Makerfabs/ESP32-S3-Parallel-TFT-with-Touch-7inch/example/ESP32_Display_Panel/README.md

This example demonstrates how to run the Espressif ESP32_Display_Pane library on 
[MaTouch ESP32-S3 Parallel TFT with Touch 7"](https://github.com/esp-arduino-libs/ESP32_Display_Panel/releases)

More detailed information you can get from 


## Preparation

📖 Here are the usage guides for ESP32_Display_Panel in Arduino development environments:

* [Arduino IDE 2.3.4](./docs/envs/use_with_arduino.md)

## Supported Boards

📋 Here is the list of boards supported by ESP32_Display_Panel:

| **Manufacturer** | **Model** |
| --- | --- |
| [Makerfabs] |MaTouch ESP32-S3 Parallel TFT with Touch 7"  |

## Supported Controllers

### LCD Controllers

📌 Here is the list of LCD controllers useded by MaTouch ESP32-S3 Parallel TFT with Touch 7":

| **Manufacturer** | **Model** |
| --- | --- |
| Sitronix | ST7262 |

### Touch Controllers

📋 Here is the list of touch controllers used by MaTouch ESP32-S3 Parallel TFT with Touch 7":

| **Manufacturer** | **Model** |
| --- | --- |
| GOODiX | GT911 |

## How to Use

1. Install ESP32 package v3.1.1 first and replace with the esp32-3.1.1-h[high_perf version](https://github.com/esp-arduino-libs/ESP32_Display_Panel/blob/master/docs/envs/use_with_arduino.md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)

2. Install Espressif ESP32_Display_Panel Library 1.0.2

3. Open the example with Arduino IDE 2.3.4 or above.
   
3.1 Select Board ESP32S3 Dev Module

3.2 Select PSRAM from none to “OPI PSRAM”

## Compiled info
Using library ESP32_Display_Panel at version 1.0.2 in folder: C:\Users\miand\Documents\Arduino\libraries\ESP32_Display_Panel 

Using library esp-lib-utils at version 0.1.2 in folder: C:\Users\miand\Documents\Arduino\libraries\esp-lib-utils 

Using library ESP32_IO_Expander at version 1.0.1 in folder: C:\Users\miand\Documents\Arduino\libraries\ESP32_IO_Expander 

Using library lvgl at version 8.3.11 in folder: C:\Users\miand\Documents\Arduino\libraries\lvgl 

Using library ui at version 1.0 in folder: C:\Users\miand\Documents\Arduino\libraries\ui
