Makerfabs/ESP32-S3-Parallel-TFT-with-Touch-7inch/(threads)

Thread 1 (2023-11-11):

LvglWidgets example code gives error: [Wire.cpp:513] requestFrom(): i2cRead returned Error -1

juswes, 2023-11-11:
When trying out the LvglWidgets example code I keep getting the error: [Wire.cpp:513] requestFrom(): i2cRead returned Error -1 via the serial monitor log. And the CPU keeps running at 95%, making the touch display unusable. It think it might have to do with this issue: https://forum.lvgl.io/t/arduino-lvgl-i2c-problem/10551/3

Any idea what is going on / how to fix this?

juswes, 2023-12-24:
I found the issue. The "pin_init()" function is not present in the "touch.h" file for this example code.
And also, "pin_init();" is never called in "setup()".

That's why touch was not working in this example code and I got the error:
[Wire.cpp:513] requestFrom(): i2cRead returned Error -1

When adding the "pin_init()" function in the "touch.h"  and calling "pin_init();" in "setup()" the code is working.

Closed 2023-12-24.

Thread 2 (2023-12-18):

Missing Audio.h file for esp32s3_7_tft_fw_test

QnBarb, 2023-12-18:
Hello,
For the example esp32s3_7_tft_fw_test, the Audio.h file is missing. Please advise.
Thanks.

Thread 4 (2024-02-02):

Error

malga6en, 2024-02-02:
**My Code:**

#include <Arduino_GFX_Library.h>
#include <TAMC_GT911.h>
#include <Wire.h>

#define SCREEN_HD
//#define SCREEN_NORMAL

#define I2C_SDA_PIN 17
#define I2C_SCL_PIN 18
#define TOUCH_INT -1
#define TOUCH_RST 38
#define TFT_BL 10

#ifdef SCREEN_HD
#define SCREEN_W 1024
#define SCREEN_H 600
#define TOUCH_ROTATION ROTATION_INVERTED
#endif

#ifdef SCREEN_NORMAL
#define SCREEN_W 800
#define SCREEN_H 480
#define TOUCH_ROTATION ROTATION_NORMAL
#endif

Arduino_ESP32RGBPanel *bus = new Arduino_ESP32RGBPanel(
    GFX_NOT_DEFINED /* CS */, GFX_NOT_DEFINED /* SCK */, GFX_NOT_DEFINED /* SDA */,
    40 /* DE */, 41 /* VSYNC */, 39 /* HSYNC */, 42 /* PCLK */,
    45 /* R0 */, 48 /* R1 */, 47 /* R2 */, 21 /* R3 */, 14 /* R4 */,
    5 /* G0 */, 6 /* G1 */, 7 /* G2 */, 15 /* G3 */, 16 /* G4 */, 4 /* G5 */,
    8 /* B0 */, 3 /* B1 */, 46 /* B2 */, 9 /* B3 */, 1 /* B4 */
);

Arduino_RPi_DPI_RGBPanel *gfx = new Arduino_RPi_DPI_RGBPanel(
    bus,
    SCREEN_W /* width */, 1 /* hsync_polarity */, 40 /* hsync_front_porch */, 48 /* hsync_pulse_width */, 128 /* hsync_back_porch */,
    SCREEN_H /* height */, 1 /* vsync_polarity */, 13 /* vsync_front_porch */, 3 /* vsync_pulse_width */, 45 /* vsync_back_porch */);

TAMC_GT911 ts = TAMC_GT911(I2C_SDA_PIN, I2C_SCL_PIN, TOUCH_INT, TOUCH_RST, 1024, 600);

int w = SCREEN_W;
int h = SCREEN_H;

int touch_last_x = 0;
int touch_last_y = 0;

void setup()
{

    Serial.begin(115200);
    Serial.println("ESP32S3 7inch LCD");

    pin_init();
    touch_init();

    // Init Display
    gfx->begin();

    gfx->fillScreen(WHITE);
    gfx->fillRect(0, 0, 50, 50, RED);
}

void loop()
{
    touch_read();
    gfx->fillRect(touch_last_x, touch_last_y, 10, 10, BLACK);
    delay(10);
}

//-------------------------------------------------------------------------

void pin_init()
{
    pinMode(TFT_BL, OUTPUT);
    pinMode(TOUCH_RST, OUTPUT);

    digitalWrite(TFT_BL, LOW);
    delay(100);
    digitalWrite(TOUCH_RST, LOW);
    delay(1000);
    digitalWrite(TOUCH_RST, HIGH);
    delay(1000);
    digitalWrite(TOUCH_RST, LOW);
    delay(1000);
    digitalWrite(TOUCH_RST, HIGH);
    delay(1000);
}

void touch_init(void)
{
    Wire.begin(I2C_SDA_PIN, I2C_SCL_PIN);
    ts.begin();
    ts.setRotation(TOUCH_ROTATION);
}

void touch_read()
{
    ts.read();
    if (ts.isTouched)
    {
#ifdef SCREEN_HD
        touch_last_x = map(ts.points[0].x, 0, 1024, 0, SCREEN_W);
        touch_last_y = map(ts.points[0].y, 0, 750, 0, SCREEN_H);

#endif
#ifdef SCREEN_NORMAL
        touch_last_x = map(ts.points[0].x, 1024, 200, 0, SCREEN_W);
        touch_last_y = map(ts.points[0].y, 600, 120, 0, SCREEN_H);

#endif

        Serial.print("TS x: ");
        Serial.print(ts.points[0].x);
        Serial.print("TS y: ");
        Serial.print(ts.points[0].y);

        Serial.print("Display x: ");
        Serial.print(touch_last_x);
        Serial.print("Display y: ");
        Serial.println(touch_last_y);

        ts.isTouched = false;
    }
}

**ERROR:**

C:\Temp\Coding\sketch_feb02a/sketch_feb02a.ino:32: **undefined reference to `Arduino_ESP32RGBPanel::Arduino_ESP32RGBPanel**(signed char, signed char, signed char, signed char, signed char, signed char, signed char, signed char, signed char, signed char, signed char, signed char, signed char, signed char, signed char, signed char, signed char, signed char, signed char, signed char, signed char, signed char, signed char, bool)'

C:\Temp\Coding\sketch_feb02a/sketch_feb02a.ino:37: **undefined reference to `Arduino_RPi_DPI_RGBPanel::Arduino_RPi_DPI_RGBPanel**(Arduino_ESP32RGBPanel*, short, unsigned short, unsigned short, unsigned short, unsigned short, short, unsigned short, unsigned short, unsigned short, unsigned short, unsigned short, int, bool)'
collect2.exe: error: ld returned 1 exit status

I can't compile the code! I installed exactly the same libs from the tutorial:
https://wiki.makerfabs.com/MaTouch_ESP32_S3_7_Paralle_%20TFT_with_Touch.html

please Help ! 😥

Fantonrko, 2024-02-22:
Use 1.3.1 Library

Thread 5 (2024-02-02):

Which lv_conf.h file I have to make it ?

strChrisLee, 2024-02-02:
I installed just LVGL library.

when I build, below error is occur.

\arduino\libraries\lvgl\src/lv_conf_internal.h:59:18: fatal error: ../../lv_conf.h: No such file or directory
   59 |         #include "../../lv_conf.h"                /*Else assume lv_conf.h is next to the lvgl folder*/
      |                  ^~~~~~~~~~~~~~~~~

how can I fix it ? please help.

Thread 6 (2024-03-04):

Display glitching  [solution]

yashmulgaonkar, 2024-03-04:
Suggest lowering write frequency to 12KHz at line
https://github.com/Makerfabs/ESP32-S3-Parallel-TFT-with-Touch-7inch/blob/84d0554912dd25e2e2ad20042276f96831017906/example/lovyanGFX/7inch800/Matouch7.h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

Thread 7 (2024-04-27):

VSCode and PlatformIO

robouden, 2024-04-27:
Hi,

Are there sample around to use VSCode and PlatformIO ?
That would make my testing much easier.

Regards
Rob Oudendijk

sprior, 2024-06-19:
I also would really like to see this.  I got it started but the performance was really bad - I think because I didn't get the PSRAM config right.  I asked about it here but didn't get any responses: https://community.platformio.org/t/very-bad-performance-when-i-compile-makerfabs-esp32-s3-parallel-tft-with-touch-7-examples/37546

Thread 8 (2024-06-15):

demo code Erro

Th1rd-Player, 2024-06-15:
```
In file included from t:\222\OneDrive\Documents\Arduino\libraries\GFX_Library_for_Arduino\src/Arduino_GFX_Library.h:4,
                 from E:\ESP32-S3-Parallel-TFT-with-Touch-7inch-main\ESP32-S3-Parallel-TFT-with-Touch-7inch-main\example\LvglWidgets\LvglWidgets.ino:28:
t:\222\OneDrive\Documents\Arduino\libraries\GFX_Library_for_Arduino\src/Arduino_DataBus.h:161:13: error: 'i80_device_list' has not been declared
  161 |   LIST_HEAD(i80_device_list, lcd_panel_io_i80_t)
      |             ^~~~~~~~~~~~~~~
t:\222\OneDrive\Documents\Arduino\libraries\GFX_Library_for_Arduino\src/Arduino_DataBus.h:161:3: error: ISO C++ forbids declaration of 'LIST_HEAD' with no type [-fpermissive]
  161 |   LIST_HEAD(i80_device_list, lcd_panel_io_i80_t)
      |   ^~~~~~~~~
t:\222\OneDrive\Documents\Arduino\libraries\GFX_Library_for_Arduino\src/Arduino_DataBus.h:161:48: error: expected ';' at end of member declaration
  161 |   LIST_HEAD(i80_device_list, lcd_panel_io_i80_t)
      |                                                ^
      |                                                 ;
t:\222\OneDrive\Documents\Arduino\libraries\GFX_Library_for_Arduino\src/Arduino_DataBus.h:162:3: error: 'device_list' does not name a type
  162 |   device_list; // Head of i80 device list
      |   ^~~~~~~~~~~
t:\222\OneDrive\Documents\Arduino\libraries\GFX_Library_for_Arduino\src/Arduino_DataBus.h:196:3: error: ISO C++ forbids declaration of 'LIST_ENTRY' with no type [-fpermissive]
  196 |   LIST_ENTRY(lcd_panel_io_i80_t)
      |   ^~~~~~~~~~
t:\222\OneDrive\Documents\Arduino\libraries\GFX_Library_for_Arduino\src/Arduino_DataBus.h:196:32: error: expected ';' at end of member declaration
  196 |   LIST_ENTRY(lcd_panel_io_i80_t)
      |                                ^
      |                                 ;
t:\222\OneDrive\Documents\Arduino\libraries\GFX_Library_for_Arduino\src/Arduino_DataBus.h:197:3: error: 'device_list_entry' does not name a type
  197 |   device_list_entry; // Entry of i80 device list
      |   ^~~~~~~~~~~~~~~~~
In file included from t:\222\OneDrive\Documents\Arduino\libraries\GFX_Library_for_Arduino\src/Arduino_GFX_Library.h:14:
t:\222\OneDrive\Documents\Arduino\libraries\GFX_Library_for_Arduino\src/databus/Arduino_ESP32RGBPanel.h:43:3: error: 'esp_lcd_rgb_panel_frame_trans_done_cb_t' does not name a type; did you mean 'esp_lcd_panel_io_color_trans_done_cb_t'?
   43 |   esp_lcd_rgb_panel_frame_trans_done_cb_t on_frame_trans_done; // Callback, invoked after frame trans done
      |   ^~~~~~~~~~~~~~~~~~~~~~~~~~~~~~~~~~~~~~~
      |   esp_lcd_panel_io_color_trans_done_cb_t

exit status 1

Compilation error: exit status 1
```

Th1rd-Player, 2024-06-15:
The bug is fixed by simply reinstalling the esp32 board support package. you need to put 2.0.14 and it works fine.

Th1rd-Player, 2024-06-15:
Тож просто перевстановіть пакет підтримки і  все буде добре всім добра

Closed 2024-06-15.

Thread 9 (2024-06-16):

matouch7 + squarlineStudio + platformio. Unable to make it work!!

Archangel95, 2024-06-16:
My work flow started from squareline studio using the makerfab simplified template for the MaTouch 7 standard. Exported the UI and copied into a new platformio project. All the library moved to platformIO project's lib folder. Moved lv_conf.h to the lvgl folder. It compliles once I change the usbserial.print to serial.print. Once flashed, the board boot loops with this error codes:

`ESP-ROM:esp32s3-20210327
Build:Mar 27 2021
rst:0xc (RTC_SW_CPU_RST),boot:0x8 (SPI_FAST_FLASH_BOOT)
Saved PC:0x4204fd8e
SPIWP:0xee
mode:DIO, clock div:1
load:0x3fce3808,len:0x44c
load:0x403c9700,len:0xbd8
load:0x403cc700,len:0x2a80
entry 0x403c98d0
[   165][E][esp32-hal-gpio.c:102] __pinMode(): Invalid pin selected
E (7) gpio: gpio_set_level(227): GPIO output gpio_num error
E (17) gpio: gpio_set_level(227): GPIO output gpio_num error
E (23) gpio: gpio_set_level(227): GPIO output gpio_num error
[   232][E][esp32-hal-gpio.c:102] __pinMode(): Invalid pin selected
E (142) lcd_panel.rgb: esp_lcd_new_rgb_panel(151): no mem for frame buffer
ESP_ERROR_CHECK failed: esp_err_t 0x101 (ESP_ERR_NO_MEM) at 0x4037b030
file: "lib/GFX_Library_for_Arduino/src/databus/Arduino_ESP32RGBPanel.cpp" line 252
func: uint16_t* Arduino_ESP32RGBPanel::getFrameBuffer(uint16_t, uint16_t, uint16_t, uint16_t, uint16_t, uint16_t, uint16_t, uint16_t, uint16_t, uint16_t, uint16_t, int32_t)
expression: esp_lcd_new_rgb_panel(_panel_config, &_panel_handle)

abort() was called at PC 0x4037b033 on core 1

Backtrace: 0x40377c06:0x3fcebaa0 0x4037b03d:0x3fcebac0 0x40380df9:0x3fcebae0 0x4037b033:0x3fcebb60 0x42003133:0x3fcebb80 0x4200321f:0x3fcebbe0 0x42002167:0x3fcebc20 0x4202ac2a:0x3fcebc50

ELF file SHA256: e2eae6260d92d47e

Rebooting..`

Any idea of the reasons and how can I fix to make it work this board?

This is the platformio.ini config file
`[env:MaTouch7]
platform = espressif32
board = esp32-s3-devkitc-1
framework = arduino
`
Am I doing something wrong?

Have a nice day

Archangel95, 2024-06-26:
In case someone is having trouble like me use the exact lib versions shown on the wiki page then add those flags inside platformio.ini:

build_flags = -DBOARD_HAS_PSRAM
board_build.arduino.memory_type = qio_opi
board_build.f_flash = 80000000L
board_build.flash_mode = qio
board_upload.flash_size = 16MB

at least now seems to be working.

TomVanHauwaert, 2024-08-06:
The wiki page only shows a print screen of required libraries. I am unable to find some of these libraries - they don't show in the library manager. Is there another list available somewhere?

Thread 10 (2024-08-14):

Missing JPEGDEC.h file for esp32s3_7_tft_fw_test

FullStackPro, 2024-08-14:
Why is this file missing??
