Makerfabs/ESP32-S3-Parallel-TFT-with-Touch-7inch/hardware/MaTouch ESP32-S3 Parallel TFT with Touch 7“ V1.2.PDF

POWER | USB to UART

# LCD

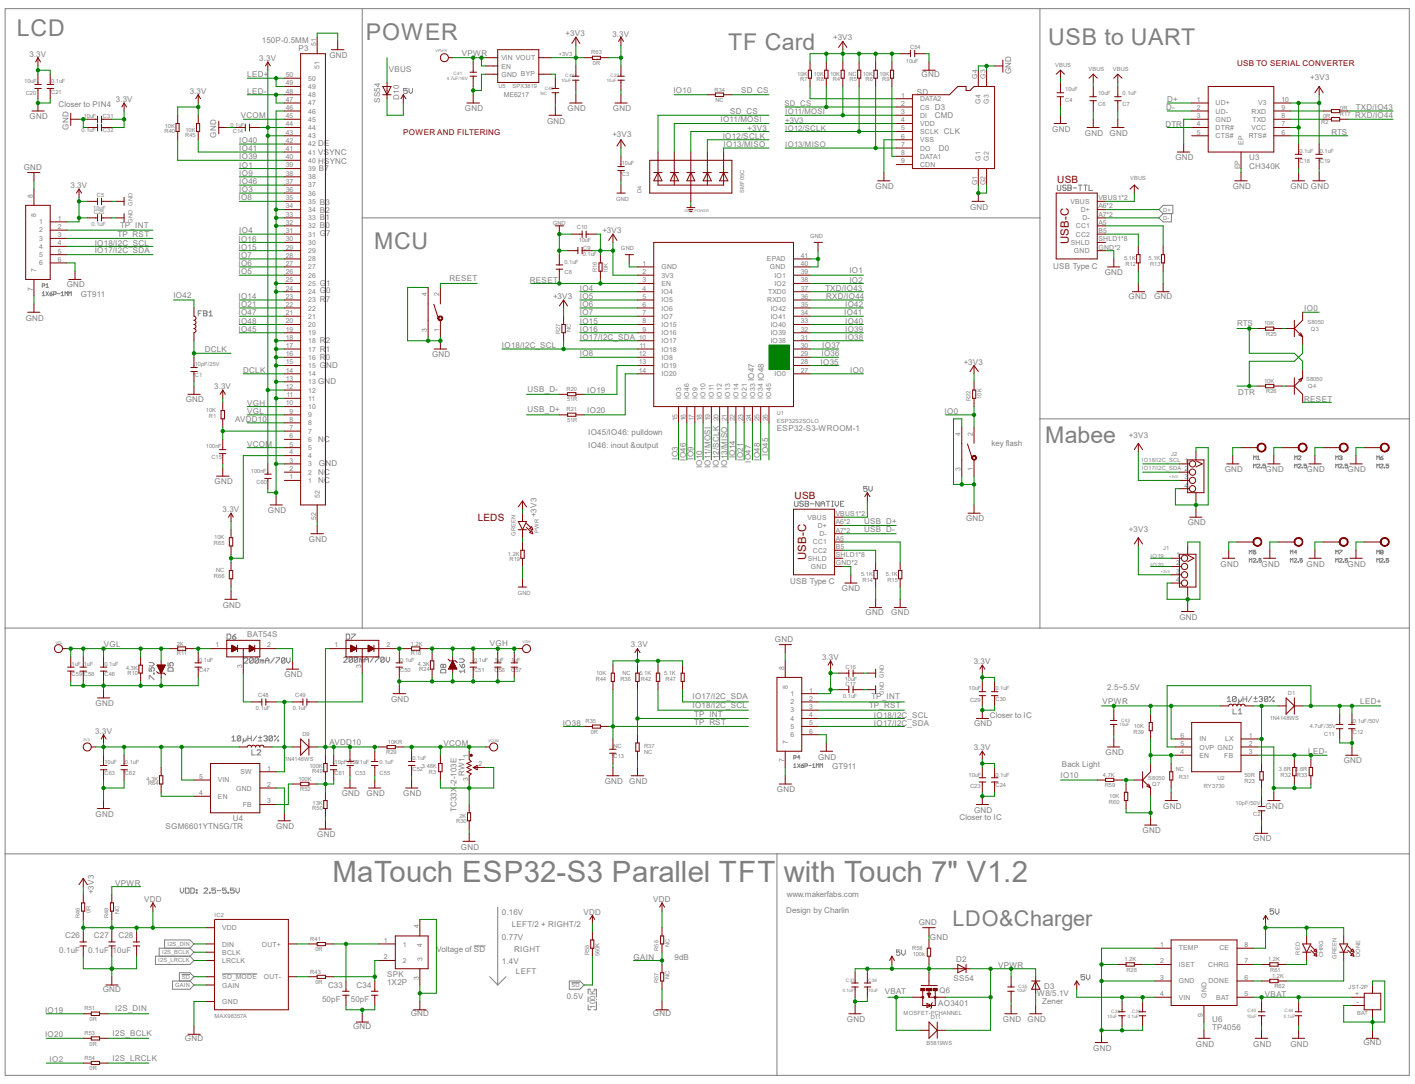
[picture p1: page 1]

USB Type C TF Card

USB TO SERIAL CONVERTER

Design by Charlin MaTouch ESP32-S3 Parallel TFT with Touch 7" V1.2
