Makerfabs/ESP32-S3-Parallel-TFT-with-Touch-7inch/hardware/MaTouch ESP32-S3 Parallel TFT with Touch 7“ V1.2.brd

## EAGLE design hardware/MaTouch ESP32-S3 Parallel TFT with Touch 7“ V1.2.brd (2023-07-18)

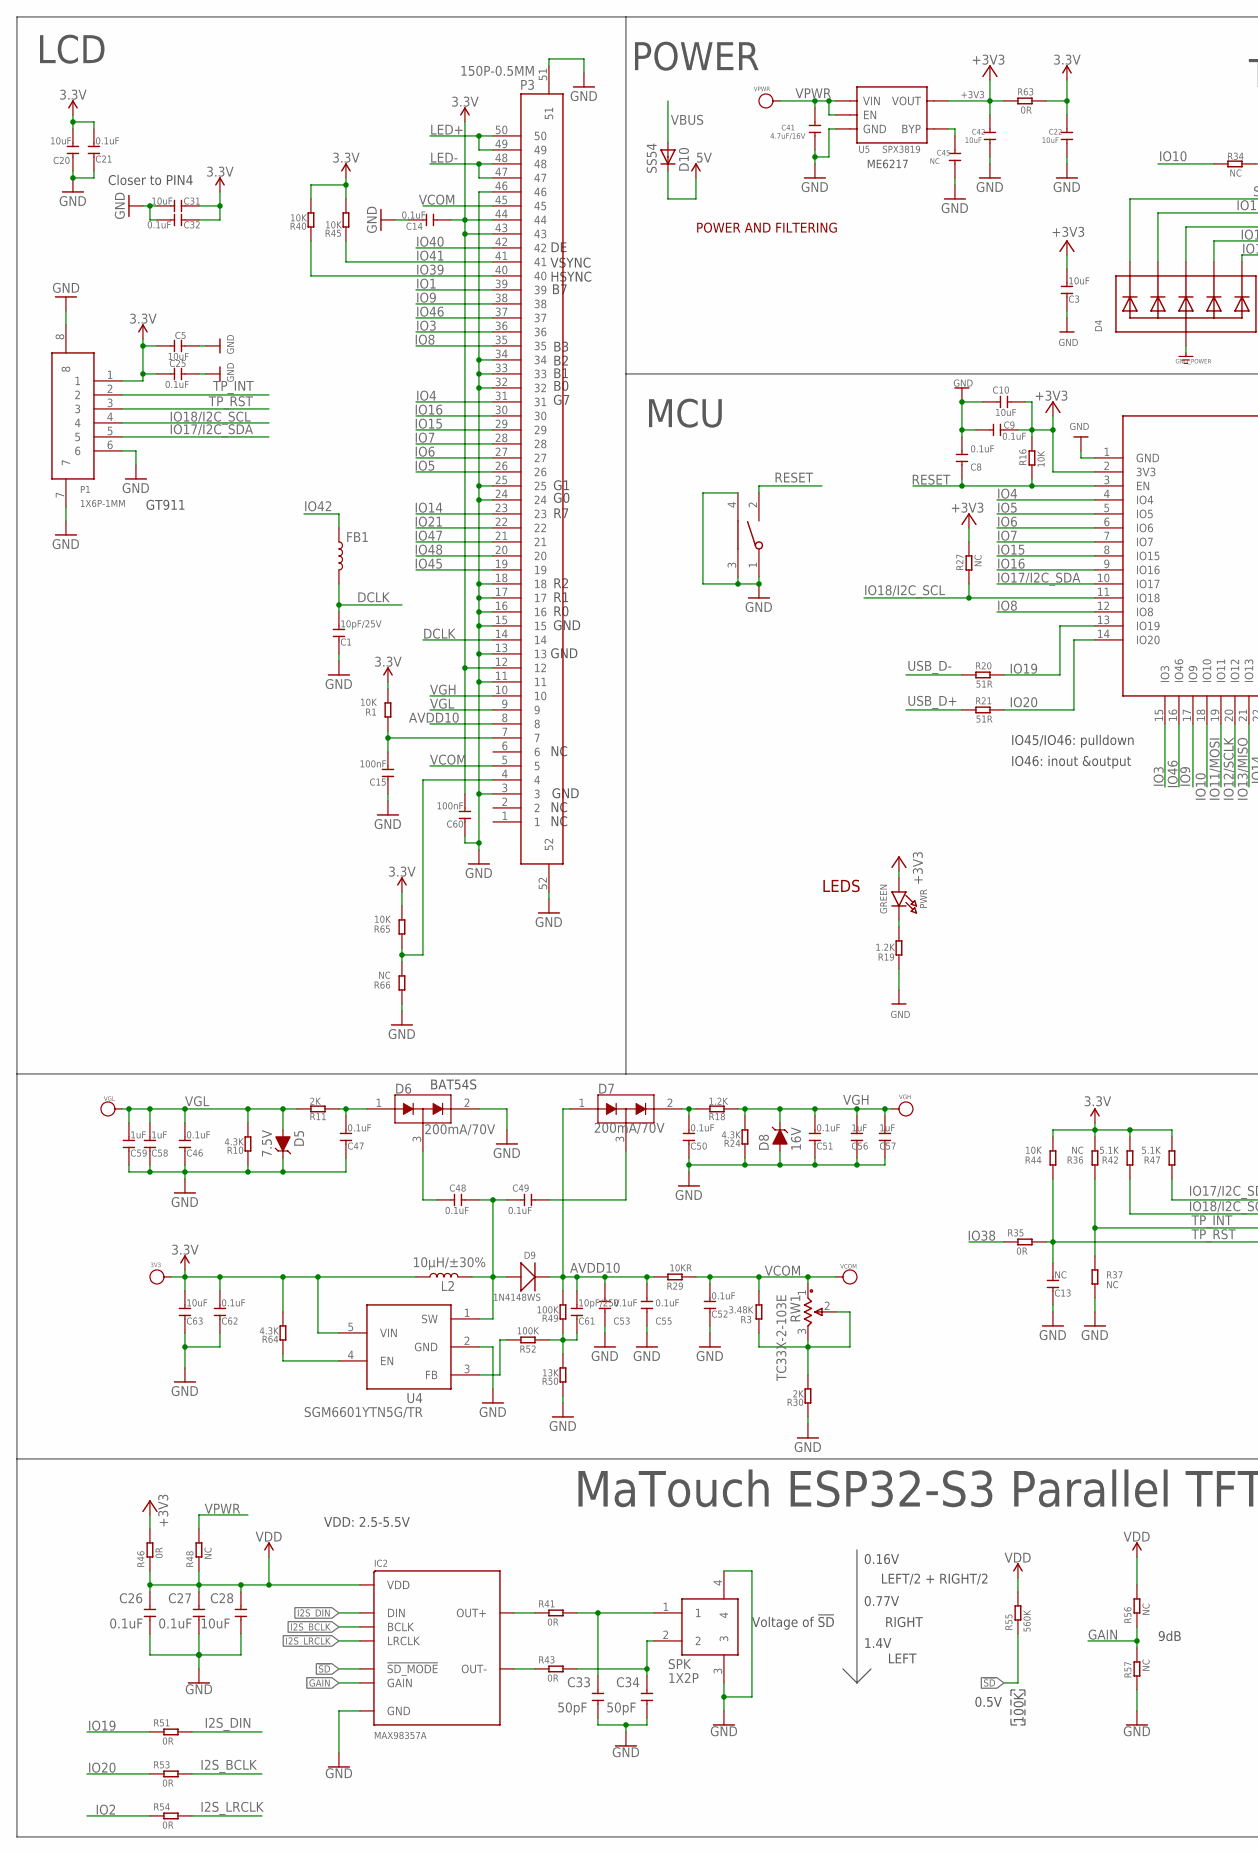
[picture p2: schematic MaTouch ESP32-S3 Parallel TFT with Touch 7“ V1.2.sch, part in row 1, column 1]

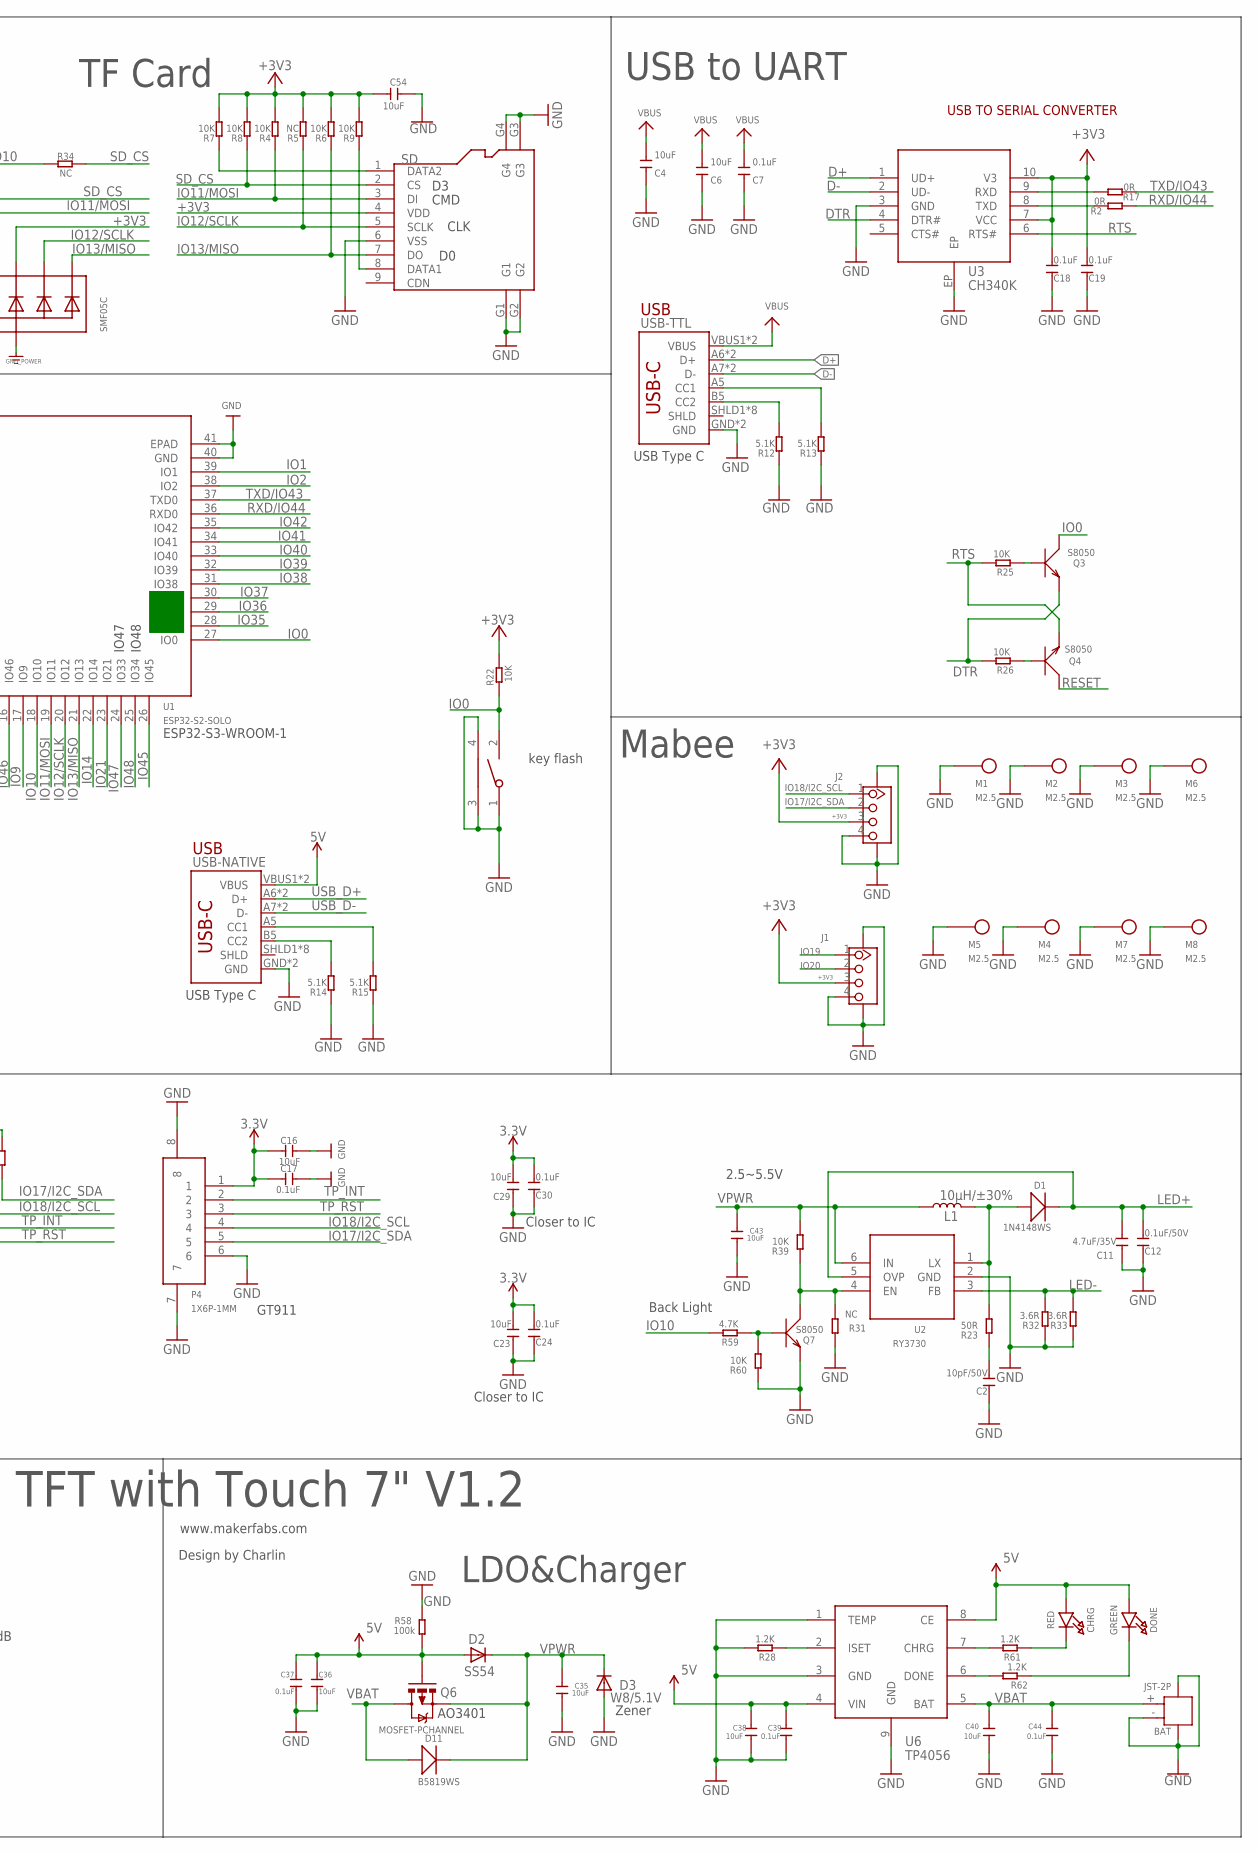
[picture p3: schematic MaTouch ESP32-S3 Parallel TFT with Touch 7“ V1.2.sch, part in row 1, column 2]

Parts:
3V3: PAD-TEST-POINT-CIRCLE'4545'; TP_4545; PARTNO DNP
BAT: JST-2P; HW2-SMD-2.0-90D
BOOT: TS24CA; 2*4*3.5MM
C1, C61: 10pF/25V; DISCRETE_C0603
C2: 10pF/50V; DISCRETE_C0603
C3, C4, C5, C6, C10, C16, C20, C23, C29, C31, C54, C63: 10uF; DISCRETE_C0603
C7, C8, C9, C14, C17, C18, C19, C21, C24, C25, C30, C32, C46, C47, C48, C49, C50, C51, C52, C53, C55, C62: 0.1uF; DISCRETE_C0603
C11: 4.7uF/35V; DISCRETE_C1206
C12: 0.1uF/50V; DISCRETE_C0603
C13: NC; DISCRETE_C0603
C15, C60: 100nF; DISCRETE_C0603
C22, C28, C35, C36, C38, C40, C42, C43: 10uF; 0603
C26, C27, C37, C39, C44: 0.1uF; 0603
C33, C34: 50pF; 0603
C41: 4.7uF/16V; 0603
C45: NC; 0603
C56, C57, C58, C59: 1uF; DISCRETE_C0603
CHRG: RED; CHIPLED_0805_NOOUTLINE
D1, D9: 1N4148WS; SOD323
D2, D10: SS54; DO-214AC
D3: W8/5.1V; SOD123
D4: SMF05C; SOT363
D5: 7.5V; SOD-323
D6, D7: 200mA/70V; SOT23-3
D8: 16V; SOD-323
D11: B5819WS; SOD323
DONE: GREEN; CHIPLED_0805_NOOUTLINE
FB1: INDUCTORFB-30OHM; 0603
IC2: MAX98357A; TQFN-16
J1, J2: GROVE-CONNECTOR-SMD'90D'; HW4-SMD-2.0-90D
L1, L2: 10µH/±30%; CR54
M1, M2, M3, M4, M5, M6, M7, M8: M2.5
P1, P4: 1X6P-1MM; 1*6P-SMT1MM
P3: 150P-0.5MM; 1*50P-SMT0.5MM
PWR: GREEN; CHIPLED_0805_NOOUTLINE
Q3, Q4, Q7: S8050; SOT23
Q6: MOSFET-PCHANNEL; SOT23-3
R1, R4, R6, R7, R8, R9, R39, R40, R44, R45, R60, R65: 10K; DISCRETE_R0603
R2, R17, R35, R41, R43, R46, R51, R53, R54, R63: 0R; R0603
R3: 3.48K; DISCRETE_R0603
R5, R31, R36, R37, R66: NC; DISCRETE_R0603
R10, R24, R64: 4.3K; DISCRETE_R0603
R11, R30: 2K; DISCRETE_R0603
R12, R13, R14, R15, R42, R47: 5.1K; DISCRETE_R0603
R16, R22, R25, R26: 10K; R0603
R18, R19: 1.2K; DISCRETE_R0603
R20, R21: 51R; R0603
R23: 50R; DISCRETE_R0603
R27, R34, R48, R56, R57: NC; R0603
R28, R61, R62: 1.2K; R0603
R29: 10KR; DISCRETE_R0603
R32, R33: 3.6R; DISCRETE_R0603
R49, R52: 100K; DISCRETE_R0603
R50: 13K; DISCRETE_R0603
R55: 560K; R0603
R58: 100k; R0603
R59: 4.7K; DISCRETE_R0603
RST: TS24CA; 2*4*3.5MM
RW1: TC33X-2-103E; TC33-3MM-SMD
SD: HOLDER-MICROSD-9P; 9P-SMD-W/-RING
SPK: 1X2P; 1X2P-SMT1.25MM
U1: ESP32­S2­SOLO; ESP32-­S2-­SOLO
U2: RY3730; SOT23-6
U3: CH340K; ESOP-10-EP-150MIL
U4: SGM6601YTN5G/TR; SOT-23-5
U5: SPX3819; SOT23-5
U6: TP4056; SOP8-1.27P
USB-NATIVE: USB_C5; USB-C-16P-5
USB-TTL: USB_C5; USB-C-16P-5
VCOM: PAD-TEST-POINT-CIRCLE'4545'; TP_4545
VGH: PAD-TEST-POINT-CIRCLE'4545'; TP_4545; PARTNO DNP
VGL: PAD-TEST-POINT-CIRCLE'4545'; TP_4545; PARTNO DNP
VPWR: PAD-TEST-POINT-CIRCLE'4545'; TP_4545; PARTNO DNP

Connections:
3.3V: 3V3.T, C5.2, C14.1, C16.2, C17.2, C20.2, C21.2, C22.1, C23.2, C24.2, C25.2, C29.2, C30.2, C31.1, C32.1, C60.2, C62.2, C63.2, L2.P$1 (1), P1.1, P3.12, P3.43, P3.44, P4.1, R1.2, R36.2, R40.2, R42.2, R44.2, R45.2, R47.2, R63.2, R64.2, R65.2, U4.5 (VIN)
5V: C36.2, C37.1, C38.1, C39.1, CHRG.A, D2.A, D10.C, DONE.A, Q6.1 (G), R58.1, U6.4 (VIN), U6.8 (CE), USB-NATIVE.VBUS1 (VBUS), USB-NATIVE.VBUS2 (VBUS)
!SD: IC2.P$4 (!SD_MODE), R55.1
+3V3: C3.2, C9.1, C10.1, C18.2, C19.2, C42.1, C54.2, D4.4 (C3), J1.3, J2.3, PWR.A, R4.2, R5.2, R6.2, R7.2, R8.2, R9.2, R16.2, R22.2, R27.2, R46.2, R63.1, SD.4 (VDD), U1.2 (3V3), U3.7 (VCC), U3.10 (V3), U5.5 (VOUT)
AVDD10: C53.2, C55.2, C61.2, D7.1 (A1), D9.-, P3.8, R29.2, R49.2
D+: U3.1 (UD+), USB-TTL.A6 (D+), USB-TTL.B6 (D+)
D-: U3.2 (UD-), USB-TTL.A7 (D-), USB-TTL.B7 (D-)
DCLK: C1.2, FB1.2, P3.14
DTR: Q3.2 (E), R26.2, U3.4 (DTR#)
GAIN: IC2.P$2 (GAIN), R56.1, R57.2
GND: BAT.3, BAT.4, BAT.- (2), BOOT.1, BOOT.3, BOOT.4, C1.1, C2.1, C3.1, C4.1, C5.1, C6.1, C7.1, C8.2, C9.2, C10.2, C11.1, C12.1, C13.1, C14.2, C15.1, C16.1, C17.1, C18.1, C19.1, C20.1, C21.1, C22.2, C23.1, C24.1, C25.1, C26.1, C27.1, C28.1, C29.1, C30.1, C31.2, C32.2, C33.1, C34.1, C35.1, C36.1, C37.2, C38.2, C39.2, C40.2, C41.2, C42.2, C43.1, C44.2, C45.2, C46.1, C47.1, C50.1, C51.1, C52.1, C53.1, C54.1, C55.1, C56.1, C57.1, C58.1, C59.1, C60.1, C62.1, C63.1, D3.A, D4.2 (A), D5.C, D6.2 (C2), D8.A, IC2.P$3 (GND), IC2.P$11 (GND), IC2.P$15 (GND), IC2.P$EP (GND), J1.4, J1.SS1, J1.SS2, J2.4, J2.SS1, J2.SS2, M1.1, M2.1, M3.1, M4.1, M5.1, M6.1, M7.1, M8.1, P1.6, P1.7, P1.8, P3.3, P3.11, P3.13, P3.15, P3.16, P3.17, P3.18, P3.24, P3.25, P3.32, P3.33, P3.34, P3.46, P3.51, P3.52, P4.6, P4.7, P4.8, Q7.2 (E), R10.1, R12.1, R13.1, R14.1, R15.1, R19.1, R24.1, R28.2, R30.1, R31.1, R32.1, R33.1, R37.2, R50.1, R57.1, R58.2, R60.1, R66.1, RST.1, RST.3, RST.4, SD.6 (VSS), SD.G1, SD.G2, SD.G3, SD.G4, SPK.3, SPK.4, U1.1 (GND), U1.40 (GND), U1.41 (EPAD), U2.2 (GND), U3.3 (GND), U3.EP, U4.2 (GND), U5.2 (GND), U6.1 (TEMP), U6.3 (GND), U6.9 (GND), USB-NATIVE.GND, USB-NATIVE.GND2 (GND), USB-TTL.GND, USB-TTL.GND2 (GND)
I2S_BCLK: IC2.P$16 (BCLK), R53.2
I2S_DIN: IC2.P$1 (DIN), R51.2
I2S_LRCLK: IC2.P$14 (LRCLK), R54.2
IO0: BOOT.2, Q3.3 (C), R22.1, U1.27 (IO0)
IO1: P3.39, U1.39 (IO1)
IO2: R54.1, U1.38 (IO2)
IO3: P3.36, U1.15 (IO3)
IO4: P3.31, U1.4 (IO4)
IO5: P3.26, U1.5 (IO5)
IO6: P3.27, U1.6 (IO6)
IO7: P3.28, U1.7 (IO7)
IO8: P3.35, U1.12 (IO8)
IO9: P3.38, U1.17 (IO9)
IO10: R34.1, R59.2, U1.18 (IO10)
IO11/MOSI: D4.3 (C2), R4.1, SD.3 (DI), U1.19 (IO11)
IO12/SCLK: D4.5 (C4), R5.1, SD.5 (SCLK), U1.20 (IO12)
IO13/MISO: D4.6 (C5), R6.1, SD.7 (DO), U1.21 (IO13)
IO14: P3.23, U1.22 (IO14)
IO15: P3.29, U1.8 (IO15)
IO16: P3.30, U1.9 (IO16)
IO17/I2C_SDA: J2.2, P1.5, P4.5, R47.1, U1.10 (IO17)
IO18/I2C_SCL: J2.1, P1.4, P4.4, R27.1, R42.1, U1.11 (IO18)
IO19: J1.1, R20.2, R51.1, U1.13 (IO19)
IO20: J1.2, R21.2, R53.1, U1.14 (IO20)
IO21: P3.22, U1.23 (IO21)
IO35: U1.28 (IO35)
IO36: U1.29 (IO36)
IO37: U1.30 (IO37)
IO38: R35.1, U1.31 (IO38)
IO39: P3.40, R40.1, U1.32 (IO39)
IO40: P3.42, U1.33 (IO40)
IO41: P3.41, R45.1, U1.34 (IO41)
IO42: FB1.1, U1.35 (IO42)
IO45: P3.19, U1.26 (IO45)
IO46: P3.37, U1.16 (IO46)
IO47: P3.21, U1.24 (IO33)
IO48: P3.20, U1.25 (IO34)
LCD_RST: C15.2, P3.7, R1.1
LED+: C11.2, C12.2, D1.-, P3.49, P3.50, U2.5 (OVP)
LED-: P3.47, P3.48, R32.2, R33.2, U2.3 (FB)
unnamed: C47.2, D6.1 (A1), R11.1
unnamed: Q4.1 (B), R26.1
unnamed: Q3.1 (B), R25.1
unnamed: C61.1, R49.1, R50.2, R52.1
unnamed: P3.4, R65.1, R66.2
unnamed: R15.2, USB-NATIVE.A5 (CC1)
unnamed: PWR.C, R19.2
unnamed: C48.2, D6.3 (COM)
unnamed: C48.1, C49.2, D9.+, L2.P$2 (2), U4.1 (SW)
unnamed: R13.2, USB-TTL.A5 (CC1)
unnamed: R12.2, USB-TTL.B5 (CC2)
unnamed: C49.1, D7.3 (COM)
unnamed: C50.2, D7.2 (C2), R18.2
unnamed: R14.2, USB-NATIVE.B5 (CC2)
unnamed: R52.2, U4.3 (FB)
unnamed: R3.1, R30.2, RW1.2, RW1.3
unnamed: D1.+, L1.P$2 (2), R23.2, U2.1 (LX)
unnamed: R64.1, U4.4 (EN)
unnamed: IC2.P$9 (OUT+), R41.1
unnamed: C2.2, R23.1
unnamed: IC2.P$10 (OUT-), R43.1
unnamed: Q7.3 (C), R31.2, R39.1, U2.4 (EN)
unnamed: C33.2, R41.2, SPK.1
unnamed: C34.2, R43.2, SPK.2
unnamed: Q7.1 (B), R59.1, R60.2
unnamed: R28.1, U6.2 (ISET)
unnamed: R61.2, U6.7 (CHRG)
unnamed: R62.2, U6.6 (DONE)
unnamed: CHRG.C, R61.1
unnamed: DONE.C, R62.1
unnamed: R17.2, U3.9 (RXD)
unnamed: R7.1, SD.1 (DATA2)
unnamed: R9.1, SD.8 (DATA1)
unnamed: R2.2, U3.8 (TXD)
unnamed: C45.1, U5.4 (BYP)
RESET: C8.1, Q4.3 (C), R16.1, RST.2, U1.3 (EN)
RTS: Q4.2 (E), R25.2, U3.6 (RTS#)
RXD/IO44: R2.1, U1.36 (RXD0)
SD_CS: D4.1 (C1), R8.1, R34.2, SD.2 (CS)
TP_INT: P1.2, P4.2, R36.1, R37.1
TP_RST: C13.2, P1.3, P4.3, R35.2, R44.1
TXD/IO43: R17.1, U1.37 (TXD0)
USB_D+: R21.1, USB-NATIVE.A6 (D+), USB-NATIVE.B6 (D+)
USB_D-: R20.1, USB-NATIVE.A7 (D-), USB-NATIVE.B7 (D-)
VBAT: BAT.+ (1), C40.1, C44.1, D11.+, Q6.3 (D), U6.5 (BAT)
VBUS: C4.2, C6.2, C7.2, D10.A, USB-TTL.VBUS1 (VBUS), USB-TTL.VBUS2 (VBUS)
VCOM: C52.2, P3.5, P3.45, R3.2, R29.1, RW1.1, VCOM.T
VDD: C26.2, C27.2, C28.2, IC2.P$7 (VDD), IC2.P$8 (VDD), R46.1, R48.1, R55.2, R56.2
VGH: C51.2, C56.2, C57.2, D8.C, P3.10, R18.1, R24.2, VGH.T
VGL: C46.2, C58.2, C59.2, D5.A, P3.9, R10.2, R11.2, VGL.T
VPWR: C35.2, C41.1, C43.2, D2.C, D3.C, D11.-, L1.P$1 (1), Q6.2 (S), R39.2, R48.2, U2.6 (IN), U5.1 (VIN), U5.3 (EN), VPWR.T

Notes on the sheet:
www.makerfabs.com
Design by Charlin
USB
LEDS
POWER AND FILTERING
USB TO SERIAL CONVERTER
MaTouch ESP32-S3 Parallel TFT with Touch 7" V1.2
POWER
USB to UART
USB Type C
TF Card
GT911
Closer to IC
Back Light
IO45/IO46: pulldown
IO46: inout &output
Mabee
LCD
MCU
ESP32-S3-WROOM-1
IO47
IO48
Closer to PIN4
VDD: 2.5-5.5V
0.16V
0.77V
1.4V
LEFT/2 + RIGHT/2
RIGHT
LEFT
0.5V
100K
9dB
Voltage of !SD
LDO&Charger
AO3401
ME6217
VSYNC
HSYNC
GND
BAT54S
key flash
CMD
CLK
2.5~5.5V
Zener

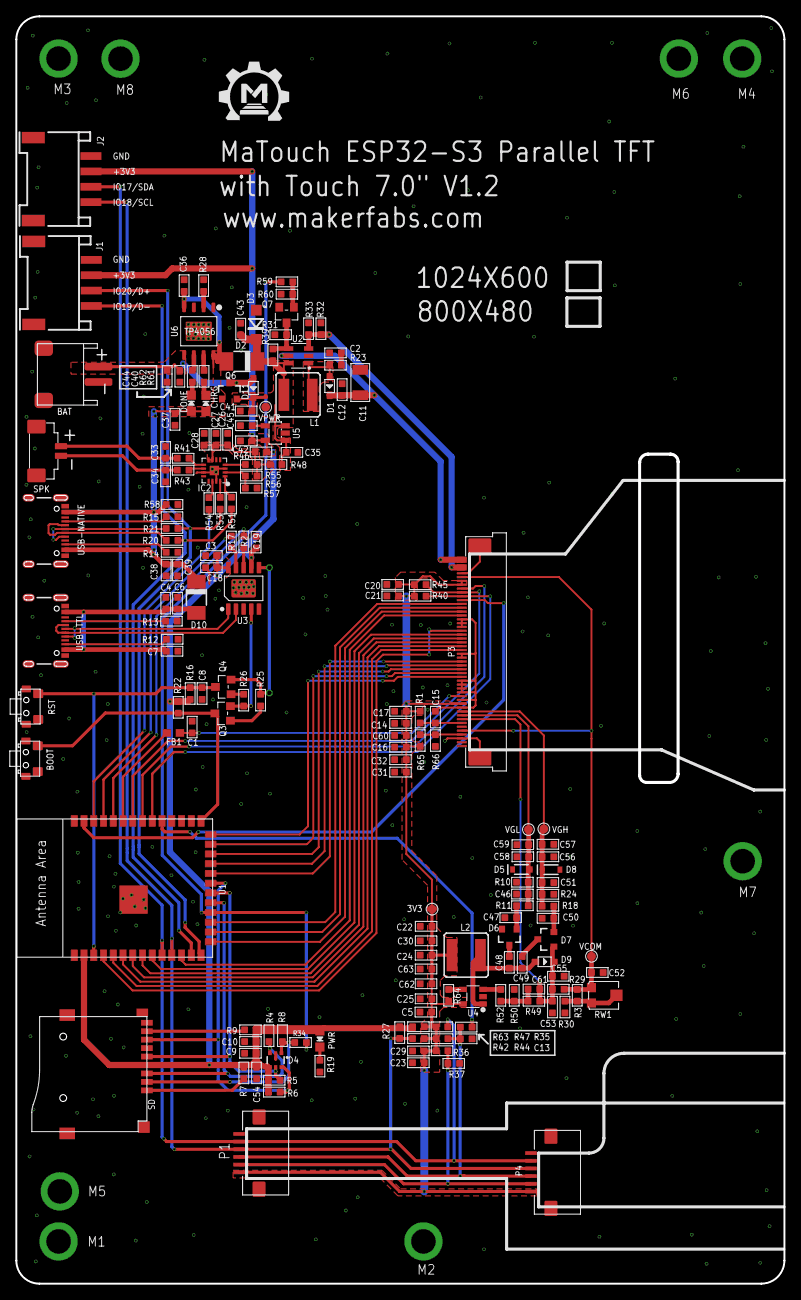
[picture p4: board MaTouch ESP32-S3 Parallel TFT with Touch 7“ V1.2.brd from above]

Board: 2 copper layers, 100.0 x 165.0 mm, 183 parts (0 on the bottom side), 99 nets.

Other parts of the board:
U$1: MAKERFABS_0.3
