Makerfabs/ESP32-S3-Parallel-TFT-with-Touch-7inch/example/esp32s3_7_tft_fw_test/esp32s3_7_tft_fw_test.ino

#include <Arduino_GFX_Library.h>
#include <SD_MMC.h>
#include <TAMC_GT911.h>
#include <Wire.h>
#include <Audio.h>
#include "JpegFunc.h"

#define SCREEN_HD
//#define SCREEN_NORMAL

#define JPEG_FILENAME_LOGO "/logo.jpg"
#define JPEG_FILENAME_COVER "/cover.jpg"
#define JPEG_FILENAME_COVER_01 "/cover01.jpg"

#define I2S_DOUT 19
#define I2S_BCLK 20
#define I2S_LRC 2

// microSD card
#define PIN_SD_CMD 11
#define PIN_SD_CLK 12
#define PIN_SD_D0 13

#define I2C_SDA_PIN 17
#define I2C_SCL_PIN 18
#define TOUCH_INT -1
#define TOUCH_RST 38

#define TOUCH_ROTATION ROTATION_NORMAL

#define TFT_BL 10

#ifdef SCREEN_HD
#define SCREEN_W 1024
#define SCREEN_H 600
#endif

#ifdef SCREEN_NORMAL
#define SCREEN_W 800
#define SCREEN_H 480
#endif

Arduino_ESP32RGBPanel *bus = new Arduino_ESP32RGBPanel(
    GFX_NOT_DEFINED /* CS */, GFX_NOT_DEFINED /* SCK */, GFX_NOT_DEFINED /* SDA */,
    40 /* DE */, 41 /* VSYNC */, 39 /* HSYNC */, 42 /* PCLK */,
    45 /* R0 */, 48 /* R1 */, 47 /* R2 */, 21 /* R3 */, 14 /* R4 */,
    5 /* G0 */, 6 /* G1 */, 7 /* G2 */, 15 /* G3 */, 16 /* G4 */, 4 /* G5 */,
    8 /* B0 */, 3 /* B1 */, 46 /* B2 */, 9 /* B3 */, 1 /* B4 */
);

#ifdef SCREEN_NORMAL
Arduino_RPi_DPI_RGBPanel *gfx = new Arduino_RPi_DPI_RGBPanel(
    bus,
    800 /* width */, 0 /* hsync_polarity */, 210 /* hsync_front_porch */, 30 /* hsync_pulse_width */, 16 /* hsync_back_porch */,
    480 /* height */, 0 /* vsync_polarity */, 22 /* vsync_front_porch */, 13 /* vsync_pulse_width */, 10 /* vsync_back_porch */,
    1 /* pclk_active_neg */, 16000000 /* prefer_speed */, true /* auto_flush */);
#endif

#ifdef SCREEN_HD
Arduino_RPi_DPI_RGBPanel *gfx = new Arduino_RPi_DPI_RGBPanel(
    bus,
    SCREEN_W /* width */, 1 /* hsync_polarity */, 40 /* hsync_front_porch */, 48 /* hsync_pulse_width */, 128 /* hsync_back_porch */,
    SCREEN_H /* height */, 1 /* vsync_polarity */, 13 /* vsync_front_porch */, 3 /* vsync_pulse_width */, 45 /* vsync_back_porch */,
    1 /* pclk_active_neg */, 16000000 /* prefer_speed */, true /* auto_flush */);
#endif

TAMC_GT911 ts = TAMC_GT911(I2C_SDA_PIN, I2C_SCL_PIN, TOUCH_INT, TOUCH_RST, SCREEN_W, SCREEN_H);

Audio audio;

String img_list[5] =
    {
        "/image01.jpg",
        "/image02.jpg",
        "/image03.jpg",
        "/image04.jpg",
        "/image05.jpg"};

struct Music_info
{
  String name;
  int length;
  int runtime;
  int volume;
  int status;
  int mute_volume;
} music_info = {"", 0, 0, 0, 0, 0};

String music_list[20];
int music_num = 0;
int music_index = 0;

int touch_last_x = 0;
int touch_last_y = 0;

int ColorArray[] = {WHITE, BLUE, GREEN, RED, YELLOW, BLACK};

TaskHandle_t audio_handle;

void setup()
{

  Serial.begin(115200);
  Serial.println("ESP32S3 7inch LCD");

  pin_init();
  touch_init();

  // Init Display
  gfx->begin();

  SD_MMC.setPins(PIN_SD_CLK, PIN_SD_CMD, PIN_SD_D0);
  if (!SD_MMC.begin("/sdcard", true, true))
  {

    while (1)
    {
      Serial.println("Card Mount Failed");
      delay(1000);
    }
  }

  audio_init();
  open_new_song(music_list[0]);

  xTaskCreatePinnedToCore(Task_Audio, "Task_Audio", 10240, NULL, 3, &audio_handle, ARDUINO_RUNNING_CORE);

  for (int i = 0; i < 6; i++)
  {
    gfx->fillScreen(ColorArray[i]);
    delay(1000);
  }

  jpegDraw(JPEG_FILENAME_LOGO, jpegDrawCallback, true /* useBigEndian */,
           0 /* x */, 0 /* y */, gfx->width() /* widthLimit */, gfx->height() /* heightLimit */);
  delay(1000);

   jpegDraw(JPEG_FILENAME_COVER_01, jpegDrawCallback, true /* useBigEndian */,
            0 /* x */, 0 /* y */, gfx->width() /* widthLimit */, gfx->height() /* heightLimit */);
  // delay(500);

  /*gfx->fillScreen(WHITE);
  gfx->setTextColor(BLACK);
  gfx->setTextSize(4);
  gfx->setCursor(0, 10);
  gfx->println("ESP32-S3 Parallel TFT with Touch 7\"");
  gfx->setCursor(10, 100);
  gfx->println("3 points touch to continue...");*/

  while (1)
  {
    ts.read();
    if (ts.isTouched)
    {
      for (int i = 0; i < ts.touches; i++)
      {
        // gfx->fillScreen(WHITE);
        int temp = random(0, 6);
        gfx->fillScreen(ColorArray[temp]);

        gfx->setTextSize(4);

        if (temp == 4)
          gfx->setTextColor(WHITE);
        else
          gfx->setTextColor(RED);

        gfx->setCursor(SCREEN_W / 2, SCREEN_H / 2);
        gfx->print("X: ");
        gfx->println(String(ts.points[i].x));
        gfx->setCursor(SCREEN_W / 2, SCREEN_H / 2 + 100);
        gfx->print("Y: ");
        gfx->println(String(ts.points[i].y));

        // RTCShow(0);

        Serial.print("Touch ");
        Serial.print(i + 1);
        Serial.print(": ");
        ;
        Serial.print("  x: ");
        Serial.print(ts.points[i].x);
        Serial.print("  y: ");
        Serial.print(ts.points[i].y);
        Serial.print("  size: ");
        Serial.println(ts.points[i].size);
        Serial.println(' ');
      }

      ts.isTouched = false;
      if (ts.touches > 2)
        break;
    }
    delay(100);
  }

  xTaskCreatePinnedToCore(Task_TFT, "Task_TFT", 20480, NULL, 2, NULL, ARDUINO_RUNNING_CORE);
}

void Task_TFT(void *pvParameters) // This is a task.
{
  while (1)
     for (int i = 0; i < 5; i++)
     {
       Serial.println(img_list[i].c_str());
       jpegDraw(img_list[i].c_str(), jpegDrawCallback, true /* useBigEndian */,
                0 /* x */, 0 /* y */, SCREEN_W /* widthLimit */, SCREEN_H /* heightLimit */);

       vTaskDelay(1000);
     }

    //graph_test();
}

void Task_Audio(void *pvParameters) // This is a task.
{
  while (1)
    audio.loop();
}

void loop()
{
}

//-------------------------------------------------------------------------

void pin_init()
{
  pinMode(TFT_BL, OUTPUT);
  pinMode(TOUCH_RST, OUTPUT);

  digitalWrite(TFT_BL, LOW);
  delay(100);
  digitalWrite(TOUCH_RST, LOW);
  delay(1000);
  digitalWrite(TOUCH_RST, HIGH);
  delay(1000);
  digitalWrite(TOUCH_RST, LOW);
  delay(1000);
  digitalWrite(TOUCH_RST, HIGH);
  delay(1000);
}

// pixel drawing callback
static int jpegDrawCallback(JPEGDRAW *pDraw)
{
  // Serial.printf("Draw pos = %d,%d. size = %d x %d\n", pDraw->x, pDraw->y, pDraw->iWidth, pDraw->iHeight);
  gfx->draw16bitBeRGBBitmap(pDraw->x, pDraw->y, pDraw->pPixels, pDraw->iWidth, pDraw->iHeight);
  return 1;
}

void touch_init(void)
{
  Wire.begin(I2C_SDA_PIN, I2C_SCL_PIN);
  ts.begin();
  ts.setRotation(TOUCH_ROTATION);
}

void audio_init()
{
  // Read SD
  music_num = get_music_list(SD_MMC, "/", 0, music_list);
  Serial.print("Music file count:");
  Serial.println(music_num);
  Serial.println("All music:");
  for (int i = 0; i < music_num; i++)
  {
    Serial.println(music_list[i]);
  }

  audio.setPinout(I2S_BCLK, I2S_LRC, I2S_DOUT);
  audio.setVolume(21); // 0...21
}

void open_new_song(String filename)
{
  // 去掉文件名的根目录"/"和文件后缀".mp3",".wav"
  music_info.name = filename.substring(1, filename.indexOf("."));
  audio.connecttoFS(SD_MMC, filename.c_str());
  music_info.runtime = audio.getAudioCurrentTime();
  music_info.length = audio.getAudioFileDuration();
  music_info.volume = audio.getVolume();
  music_info.status = 1;
  Serial.println("**********start a new sound************");
}

int get_music_list(fs::FS &fs, const char *dirname, uint8_t levels, String wavlist[30])
{
  Serial.printf("Listing directory: %s\n", dirname);
  int i = 0;

  File root = fs.open(dirname);
  if (!root)
  {
    Serial.println("Failed to open directory");
    return i;
  }
  if (!root.isDirectory())
  {
    Serial.println("Not a directory");
    return i;
  }

  File file = root.openNextFile();
  while (file)
  {
    if (file.isDirectory())
    {
    }
    else
    {
      String temp = file.name();
      if (temp.endsWith(".wav"))
      {
        wavlist[i] = temp;
        i++;
      }
      else if (temp.endsWith(".mp3"))
      {
        wavlist[i] = temp;
        i++;
      }
    }
    file = root.openNextFile();
  }
  return i;
}

void audio_eof_mp3(const char *info)
{ // end of file
  Serial.print("eof_mp3     ");
  Serial.println(info);
  music_index++;
  if (music_index >= music_num)
  {
    music_index = 0;
  }

  vTaskDelete(audio_handle);
  // open_new_song(music_list[music_index]);
}

// For test
int32_t w, h, n, n1, cx, cy, cx1, cy1, cn, cn1;
uint8_t tsa, tsb, tsc, ds;

static inline uint32_t micros_start() __attribute__((always_inline));
static inline uint32_t micros_start()
{
  uint8_t oms = millis();
  while ((uint8_t)millis() == oms)
    ;
  return micros();
}

void graph_test()
{
  w = gfx->width();
  h = gfx->height();
  n = min(w, h);
  n1 = n - 1;
  cx = w / 2;
  cy = h / 2;
  cx1 = cx - 1;
  cy1 = cy - 1;
  cn = min(cx1, cy1);
  cn1 = cn - 1;
  tsa = ((w <= 176) || (h <= 160)) ? 1 : (((w <= 240) || (h <= 240)) ? 2 : 3); // text size A
  tsb = ((w <= 272) || (h <= 220)) ? 1 : 2;                                    // text size B
  tsc = ((w <= 220) || (h <= 220)) ? 1 : 2;                                    // text size C
  ds = (w <= 160) ? 9 : 12;                                                    // digit size

  Serial.println(F("Benchmark\tmicro-secs"));

  int32_t usecFillScreen = testFillScreen();
  serialOut(F("Screen fill\t"), usecFillScreen, 100, true);

  int32_t usecText = testText();
  serialOut(F("Text\t"), usecText, 3000, true);

  int32_t usecPixels = testPixels();
  serialOut(F("Pixels\t"), usecPixels, 100, true);

  int32_t usecLines = testLines();
  serialOut(F("Lines\t"), usecLines, 100, true);

  int32_t usecFastLines = testFastLines();
  serialOut(F("Horiz/Vert Lines\t"), usecFastLines, 100, true);

  int32_t usecFilledRects = testFilledRects();
  serialOut(F("Rectangles (filled)\t"), usecFilledRects, 100, false);

  int32_t usecRects = testRects();
  serialOut(F("Rectangles (outline)\t"), usecRects, 100, true);

  int32_t usecFilledTrangles = testFilledTriangles();
  serialOut(F("Triangles (filled)\t"), usecFilledTrangles, 100, false);

  int32_t usecTriangles = testTriangles();
  serialOut(F("Triangles (outline)\t"), usecTriangles, 100, true);

  int32_t usecFilledCircles = testFilledCircles(10);
  serialOut(F("Circles (filled)\t"), usecFilledCircles, 100, false);

  int32_t usecCircles = testCircles(10);
  serialOut(F("Circles (outline)\t"), usecCircles, 100, true);

  int32_t usecFilledArcs = testFillArcs();
  serialOut(F("Arcs (filled)\t"), usecFilledArcs, 100, false);

  int32_t usecArcs = testArcs();
  serialOut(F("Arcs (outline)\t"), usecArcs, 100, true);

  int32_t usecFilledRoundRects = testFilledRoundRects();
  serialOut(F("Rounded rects (filled)\t"), usecFilledRoundRects, 100, false);

  int32_t usecRoundRects = testRoundRects();
  serialOut(F("Rounded rects (outline)\t"), usecRoundRects, 100, true);

#ifdef CANVAS
  uint32_t start = micros_start();
  gfx->flush();
  int32_t usecFlush = micros() - start;
  serialOut(F("flush (Canvas only)\t"), usecFlush, 0, false);
#endif

  Serial.println(F("Done!"));

  uint16_t c = 4;
  int8_t d = 1;
  for (int32_t i = 0; i < h; i++)
  {
    gfx->drawFastHLine(0, i, w, c);
    c += d;
    if (c <= 4 || c >= 11)
    {
      d = -d;
    }
  }

  gfx->setCursor(0, 0);

  gfx->setTextSize(tsa);
  gfx->setTextColor(MAGENTA);
  gfx->println(F("Arduino GFX PDQ"));

  if (h > w)
  {
    gfx->setTextSize(tsb);
    gfx->setTextColor(GREEN);
    gfx->print(F("\nBenchmark "));
    gfx->setTextSize(tsc);
    if (ds == 12)
    {
      gfx->print(F("   "));
    }
    gfx->println(F("micro-secs"));
  }

  printnice(F("Screen fill "), usecFillScreen);
  printnice(F("Text        "), usecText);
  printnice(F("Pixels      "), usecPixels);
  printnice(F("Lines       "), usecLines);
  printnice(F("H/V Lines   "), usecFastLines);
  printnice(F("Rectangles F"), usecFilledRects);
  printnice(F("Rectangles  "), usecRects);
  printnice(F("Triangles F "), usecFilledTrangles);
  printnice(F("Triangles   "), usecTriangles);
  printnice(F("Circles F   "), usecFilledCircles);
  printnice(F("Circles     "), usecCircles);
  printnice(F("Arcs F      "), usecFilledArcs);
  printnice(F("Arcs        "), usecArcs);
  printnice(F("RoundRects F"), usecFilledRoundRects);
  printnice(F("RoundRects  "), usecRoundRects);

  if ((h > w) || (h > 240))
  {
    gfx->setTextSize(tsc);
    gfx->setTextColor(GREEN);
    gfx->print(F("\nBenchmark Complete!"));
  }

#ifdef CANVAS
  gfx->flush();
#endif

  delay(60 * 1000L);
}

void serialOut(const __FlashStringHelper *item, int32_t v, uint32_t d, bool clear)
{
#ifdef CANVAS
  gfx->flush();
#endif
  Serial.print(item);
  if (v < 0)
  {
    Serial.println(F("N/A"));
  }
  else
  {
    Serial.println(v);
  }
  delay(d);
  if (clear)
  {
    gfx->fillScreen(BLACK);
  }
}

void printnice(const __FlashStringHelper *item, long int v)
{
  gfx->setTextSize(tsb);
  gfx->setTextColor(CYAN);
  gfx->print(item);

  gfx->setTextSize(tsc);
  gfx->setTextColor(YELLOW);
  if (v < 0)
  {
    gfx->println(F("      N / A"));
  }
  else
  {
    char str[32] = {0};
#ifdef RTL8722DM
    sprintf(str, "%d", (int)v);
#else
    sprintf(str, "%ld", v);
#endif
    for (char *p = (str + strlen(str)) - 3; p > str; p -= 3)
    {
      memmove(p + 1, p, strlen(p) + 1);
      *p = ',';
    }
    while (strlen(str) < ds)
    {
      memmove(str + 1, str, strlen(str) + 1);
      *str = ' ';
    }
    gfx->println(str);
  }
}

int32_t testFillScreen()
{
  uint32_t start = micros_start();
  // Shortened this tedious test!
  gfx->fillScreen(WHITE);
  gfx->fillScreen(RED);
  gfx->fillScreen(GREEN);
  gfx->fillScreen(BLUE);
  gfx->fillScreen(BLACK);

  return micros() - start;
}

int32_t testText()
{
  uint32_t start = micros_start();
  gfx->setCursor(0, 0);

  gfx->setTextSize(1);
  gfx->setTextColor(WHITE, BLACK);
  gfx->println(F("Hello World!"));

  gfx->setTextSize(2);
  gfx->setTextColor(gfx->color565(0xff, 0x00, 0x00));
  gfx->print(F("RED "));
  gfx->setTextColor(gfx->color565(0x00, 0xff, 0x00));
  gfx->print(F("GREEN "));
  gfx->setTextColor(gfx->color565(0x00, 0x00, 0xff));
  gfx->println(F("BLUE"));

  gfx->setTextSize(tsa);
  gfx->setTextColor(YELLOW);
  gfx->println(1234.56);

  gfx->setTextColor(WHITE);
  gfx->println((w > 128) ? 0xDEADBEEF : 0xDEADBEE, HEX);

  gfx->setTextColor(CYAN, WHITE);
  gfx->println(F("Groop,"));

  gfx->setTextSize(tsc);
  gfx->setTextColor(MAGENTA, WHITE);
  gfx->println(F("I implore thee,"));

  gfx->setTextSize(1);
  gfx->setTextColor(NAVY, WHITE);
  gfx->println(F("my foonting turlingdromes."));

  gfx->setTextColor(DARKGREEN, WHITE);
  gfx->println(F("And hooptiously drangle me"));

  gfx->setTextColor(DARKCYAN, WHITE);
  gfx->println(F("with crinkly bindlewurdles,"));

  gfx->setTextColor(MAROON, WHITE);
  gfx->println(F("Or I will rend thee"));

  gfx->setTextColor(PURPLE, WHITE);
  gfx->println(F("in the gobberwartsb"));

  gfx->setTextColor(OLIVE, WHITE);
  gfx->println(F("with my blurglecruncheon,"));

  gfx->setTextColor(DARKGREY, WHITE);
  gfx->println(F("see if I don't!"));

  gfx->setTextSize(2);
  gfx->setTextColor(RED);
  gfx->println(F("Size 2"));

  gfx->setTextSize(3);
  gfx->setTextColor(ORANGE);
  gfx->println(F("Size 3"));

  gfx->setTextSize(4);
  gfx->setTextColor(YELLOW);
  gfx->println(F("Size 4"));

  gfx->setTextSize(5);
  gfx->setTextColor(GREENYELLOW);
  gfx->println(F("Size 5"));

  gfx->setTextSize(6);
  gfx->setTextColor(GREEN);
  gfx->println(F("Size 6"));

  gfx->setTextSize(7);
  gfx->setTextColor(BLUE);
  gfx->println(F("Size 7"));

  gfx->setTextSize(8);
  gfx->setTextColor(PURPLE);
  gfx->println(F("Size 8"));

  gfx->setTextSize(9);
  gfx->setTextColor(PINK);
  gfx->println(F("Size 9"));

  return micros() - start;
}

int32_t testPixels()
{
  uint32_t start = micros_start();

  for (int16_t y = 0; y < h; y++)
  {
    for (int16_t x = 0; x < w; x++)
    {
      gfx->drawPixel(x, y, gfx->color565(x << 3, y << 3, x * y));
    }
#ifdef ESP8266
    yield(); // avoid long run triggered ESP8266 WDT restart
#endif
  }

  return micros() - start;
}

int32_t testLines()
{
  uint32_t start;
  int32_t x1, y1, x2, y2;

  start = micros_start();

  x1 = y1 = 0;
  y2 = h - 1;
  for (x2 = 0; x2 < w; x2 += 6)
  {
    gfx->drawLine(x1, y1, x2, y2, BLUE);
  }
#ifdef ESP8266
  yield(); // avoid long run triggered ESP8266 WDT restart
#endif

  x2 = w - 1;
  for (y2 = 0; y2 < h; y2 += 6)
  {
    gfx->drawLine(x1, y1, x2, y2, BLUE);
  }
#ifdef ESP8266
  yield(); // avoid long run triggered ESP8266 WDT restart
#endif

  x1 = w - 1;
  y1 = 0;
  y2 = h - 1;
  for (x2 = 0; x2 < w; x2 += 6)
  {
    gfx->drawLine(x1, y1, x2, y2, BLUE);
  }
#ifdef ESP8266
  yield(); // avoid long run triggered ESP8266 WDT restart
#endif

  x2 = 0;
  for (y2 = 0; y2 < h; y2 += 6)
  {
    gfx->drawLine(x1, y1, x2, y2, BLUE);
  }
#ifdef ESP8266
  yield(); // avoid long run triggered ESP8266 WDT restart
#endif

  x1 = 0;
  y1 = h - 1;
  y2 = 0;
  for (x2 = 0; x2 < w; x2 += 6)
  {
    gfx->drawLine(x1, y1, x2, y2, BLUE);
  }
#ifdef ESP8266
  yield(); // avoid long run triggered ESP8266 WDT restart
#endif

  x2 = w - 1;
  for (y2 = 0; y2 < h; y2 += 6)
  {
    gfx->drawLine(x1, y1, x2, y2, BLUE);
  }
#ifdef ESP8266
  yield(); // avoid long run triggered ESP8266 WDT restart
#endif

  x1 = w - 1;
  y1 = h - 1;
  y2 = 0;
  for (x2 = 0; x2 < w; x2 += 6)
  {
    gfx->drawLine(x1, y1, x2, y2, BLUE);
  }
#ifdef ESP8266
  yield(); // avoid long run triggered ESP8266 WDT restart
#endif

  x2 = 0;
  for (y2 = 0; y2 < h; y2 += 6)
  {
    gfx->drawLine(x1, y1, x2, y2, BLUE);
  }
#ifdef ESP8266
  yield(); // avoid long run triggered ESP8266 WDT restart
#endif

  return micros() - start;
}

int32_t testFastLines()
{
  uint32_t start;
  int32_t x, y;

  start = micros_start();

  for (y = 0; y < h; y += 5)
  {
    gfx->drawFastHLine(0, y, w, RED);
  }
  for (x = 0; x < w; x += 5)
  {
    gfx->drawFastVLine(x, 0, h, BLUE);
  }

  return micros() - start;
}

int32_t testFilledRects()
{
  uint32_t start;
  int32_t i, i2;

  start = micros_start();

  for (i = n; i > 0; i -= 6)
  {
    i2 = i / 2;

    gfx->fillRect(cx - i2, cy - i2, i, i, gfx->color565(i, i, 0));
  }

  return micros() - start;
}

int32_t testRects()
{
  uint32_t start;
  int32_t i, i2;

  start = micros_start();
  for (i = 2; i < n; i += 6)
  {
    i2 = i / 2;
    gfx->drawRect(cx - i2, cy - i2, i, i, GREEN);
  }

  return micros() - start;
}

int32_t testFilledCircles(uint8_t radius)
{
  uint32_t start;
  int32_t x, y, r2 = radius * 2;

  start = micros_start();

  for (x = radius; x < w; x += r2)
  {
    for (y = radius; y < h; y += r2)
    {
      gfx->fillCircle(x, y, radius, MAGENTA);
    }
  }

  return micros() - start;
}

int32_t testCircles(uint8_t radius)
{
  uint32_t start;
  int32_t x, y, r2 = radius * 2;
  int32_t w1 = w + radius;
  int32_t h1 = h + radius;

  // Screen is not cleared for this one -- this is
  // intentional and does not affect the reported time.
  start = micros_start();

  for (x = 0; x < w1; x += r2)
  {
    for (y = 0; y < h1; y += r2)
    {
      gfx->drawCircle(x, y, radius, WHITE);
    }
  }

  return micros() - start;
}

int32_t testFillArcs()
{
  int16_t i, r = 360 / cn;
  uint32_t start = micros_start();

  for (i = 6; i < cn; i += 6)
  {
    gfx->fillArc(cx1, cy1, i, i - 3, 0, i * r, RED);
  }

  return micros() - start;
}

int32_t testArcs()
{
  int16_t i, r = 360 / cn;
  uint32_t start = micros_start();

  for (i = 6; i < cn; i += 6)
  {
    gfx->drawArc(cx1, cy1, i, i - 3, 0, i * r, WHITE);
  }

  return micros() - start;
}

int32_t testFilledTriangles()
{
  uint32_t start;
  int32_t i;

  start = micros_start();

  for (i = cn1; i > 10; i -= 5)
  {
    gfx->fillTriangle(cx1, cy1 - i, cx1 - i, cy1 + i, cx1 + i, cy1 + i,
                      gfx->color565(0, i, i));
  }

  return micros() - start;
}

int32_t testTriangles()
{
  uint32_t start;
  int32_t i;

  start = micros_start();

  for (i = 0; i < cn; i += 5)
  {
    gfx->drawTriangle(
        cx1, cy1 - i,     // peak
        cx1 - i, cy1 + i, // bottom left
        cx1 + i, cy1 + i, // bottom right
        gfx->color565(0, 0, i));
  }

  return micros() - start;
}

int32_t testFilledRoundRects()
{
  uint32_t start;
  int32_t i, i2;

  start = micros_start();

  for (i = n1; i > 20; i -= 6)
  {
    i2 = i / 2;
    gfx->fillRoundRect(cx - i2, cy - i2, i, i, i / 8, gfx->color565(0, i, 0));
  }

  return micros() - start;
}

int32_t testRoundRects()
{
  uint32_t start;
  int32_t i, i2;

  start = micros_start();

  for (i = 20; i < n1; i += 6)
  {
    i2 = i / 2;
    gfx->drawRoundRect(cx - i2, cy - i2, i, i, i / 8, gfx->color565(i, 0, 0));
  }

  return micros() - start;
}
