Makerfabs/ESP32-S3-Parallel-TFT-with-Touch-7inch/(commit log)

2023-08-05 Add schematic of PDF version
2025-05-22 Add Espressif ESP32_Display_Panel examples
